cdhigh/PrinterCnc/Firmware/cmdlist.md

#绘图命令：
* x+00000 / x-00000
* y+00000 / y-00000
* z+00000 / z-00000
* 五位数字的单位为步进电机动作的步数。
* \+为向右或向下，\-为向左或向上。

#配置命令：
* XS000 / XE000 设定X轴的初始和最大移动速度，三位数字越小运动越快
* YS000 / YE000 设定Y轴的初始和最大移动速度，三位数字越小运动越快
* Z000 设定Z轴的移动速度，三位数字越小运动越快
* A0000 设定XY轴的加速过程加速度，四位数字越大加速越慢，为0则恒定初始速度
