cdhigh/PrinterCnc/Photos/DC电机加光栅条结构.JPG

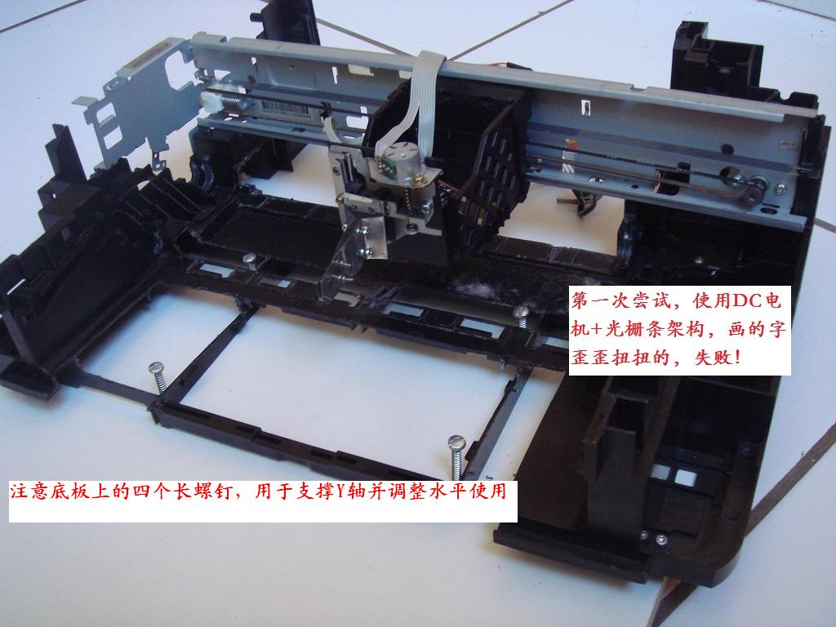
Photos/DC电机加光栅条结构.JPG
