cdhigh/PrinterCnc/Photos/DC电机驱动板.JPG

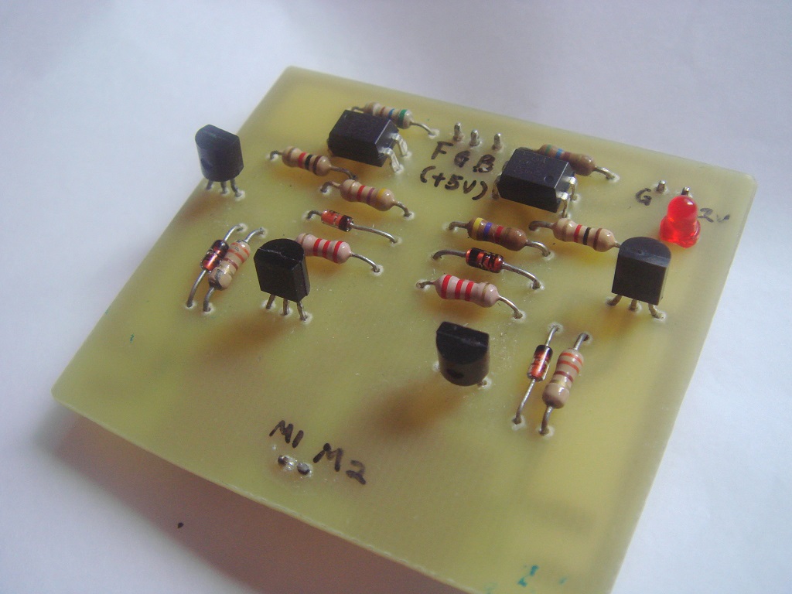
Photos/DC电机驱动板.JPG
