cdhigh/PrinterCnc/Photos/DC电机驱动板电路图.JPG

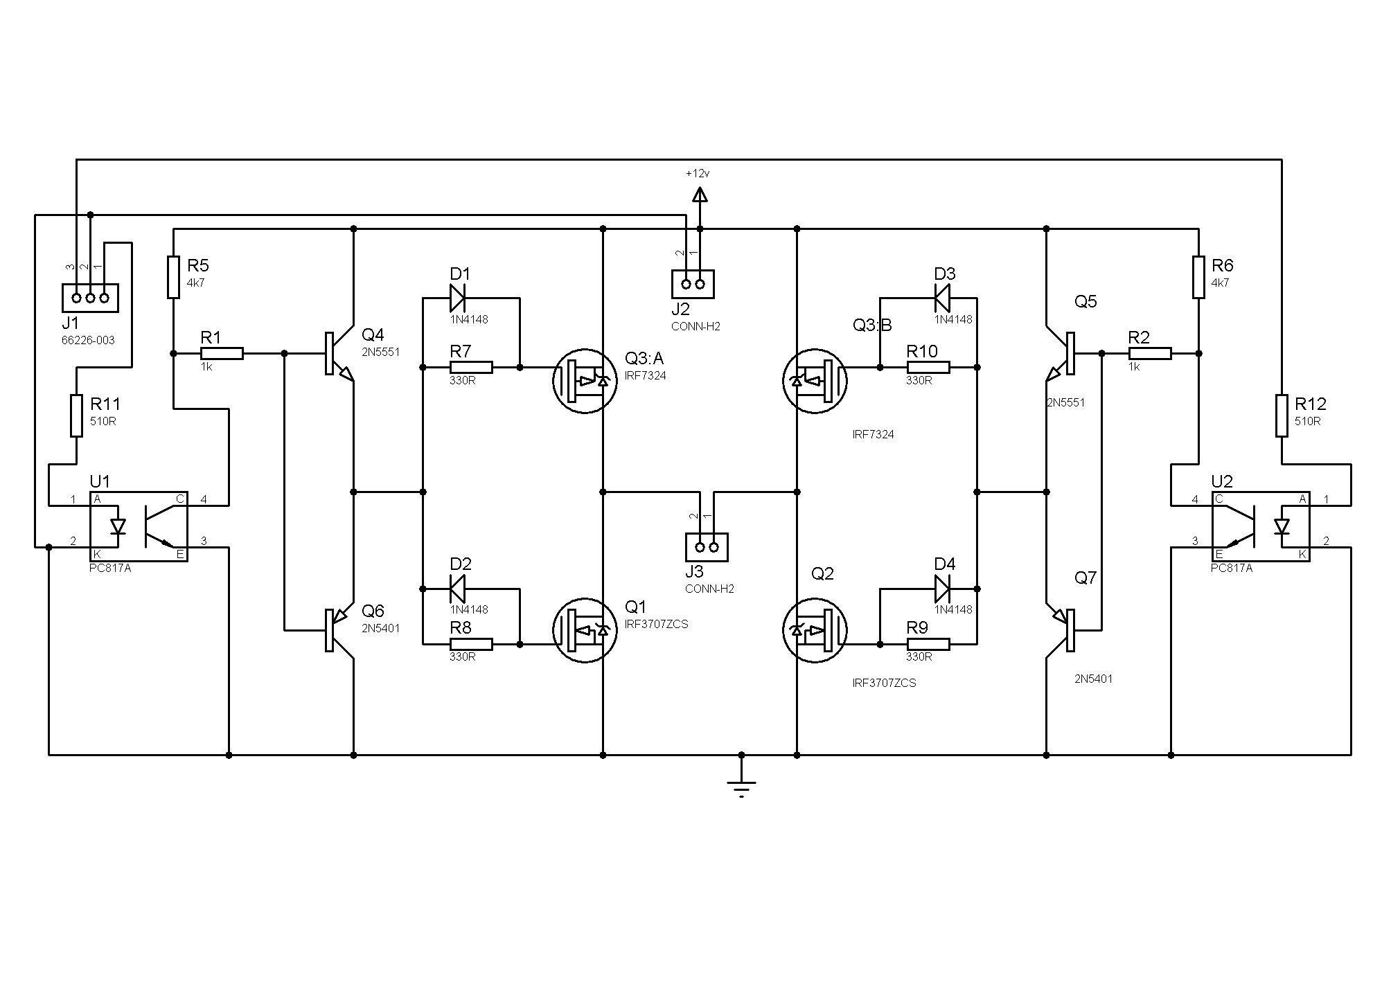
Photos/DC电机驱动板电路图.JPG
