cdhigh/PrinterCnc/Photos/DC电机驱动板背面.JPG

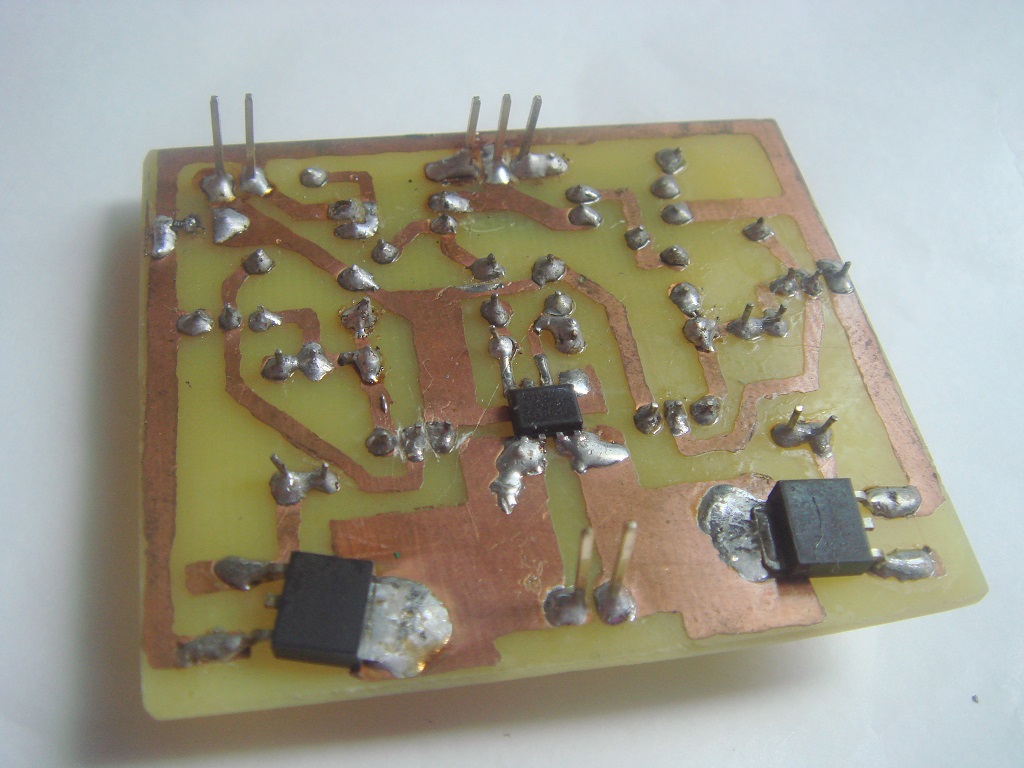
Photos/DC电机驱动板背面.JPG
