cdhigh/PrinterCnc/Photos/JDM编程器.JPG

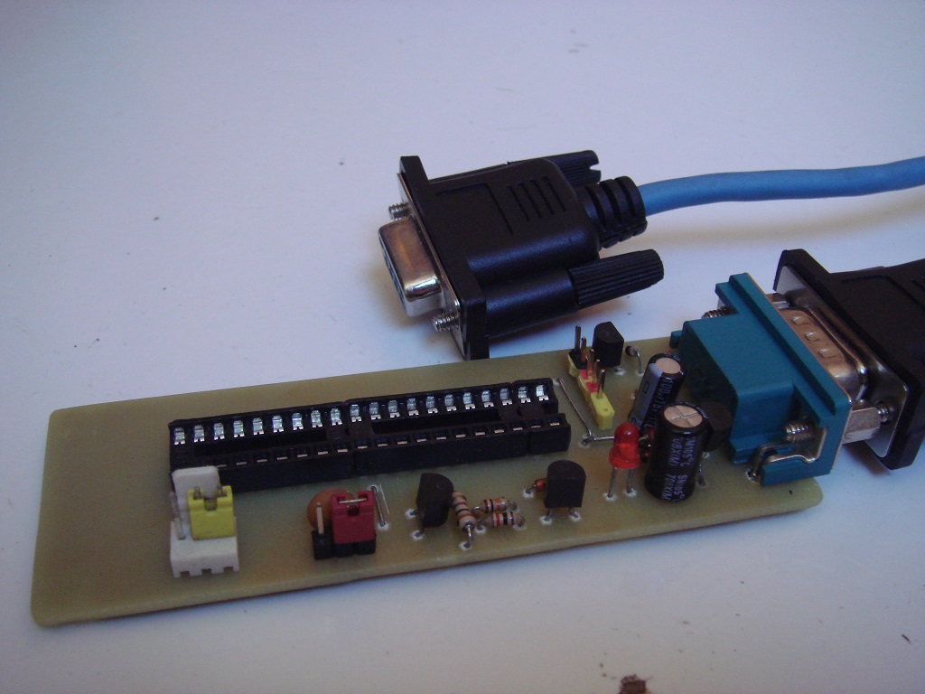
Photos/JDM编程器.JPG
