cdhigh/PrinterCnc/Photos/X轴步进电机齿轮组正面.JPG

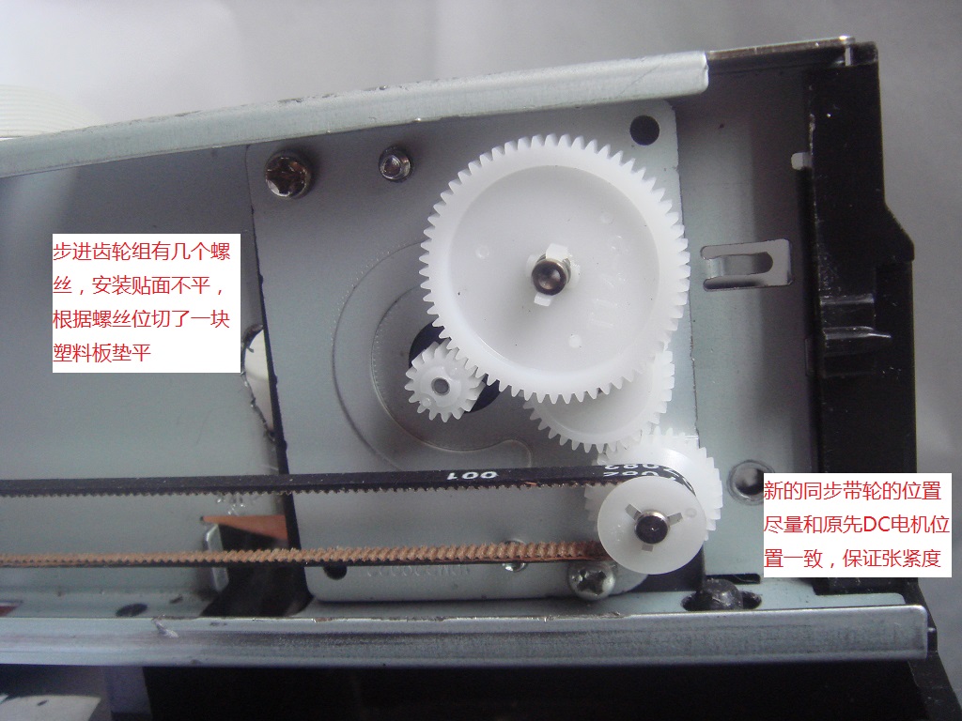
Photos/X轴步进电机齿轮组正面.JPG
