cdhigh/PrinterCnc/Photos/X轴步进电机齿轮组背面.JPG

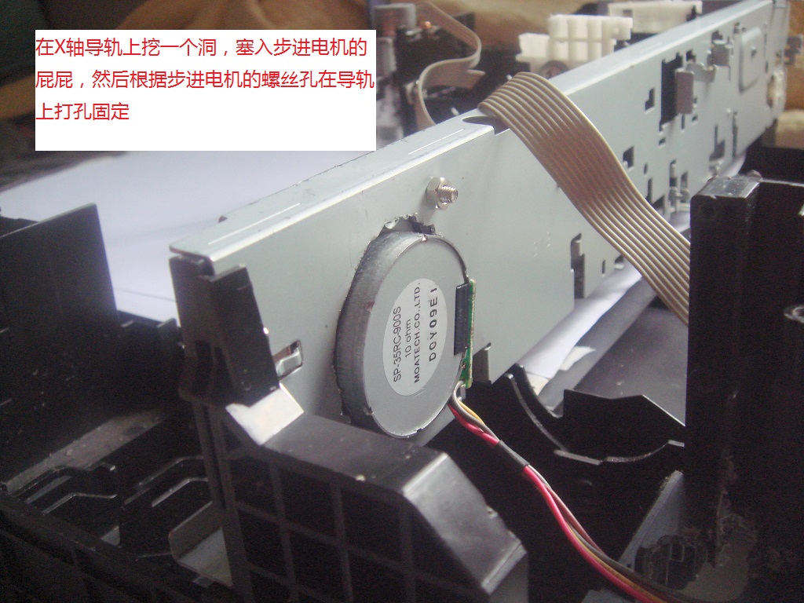
Photos/X轴步进电机齿轮组背面.JPG
