cdhigh/PrinterCnc/Photos/Y轴支撑平台固定角铝.JPG

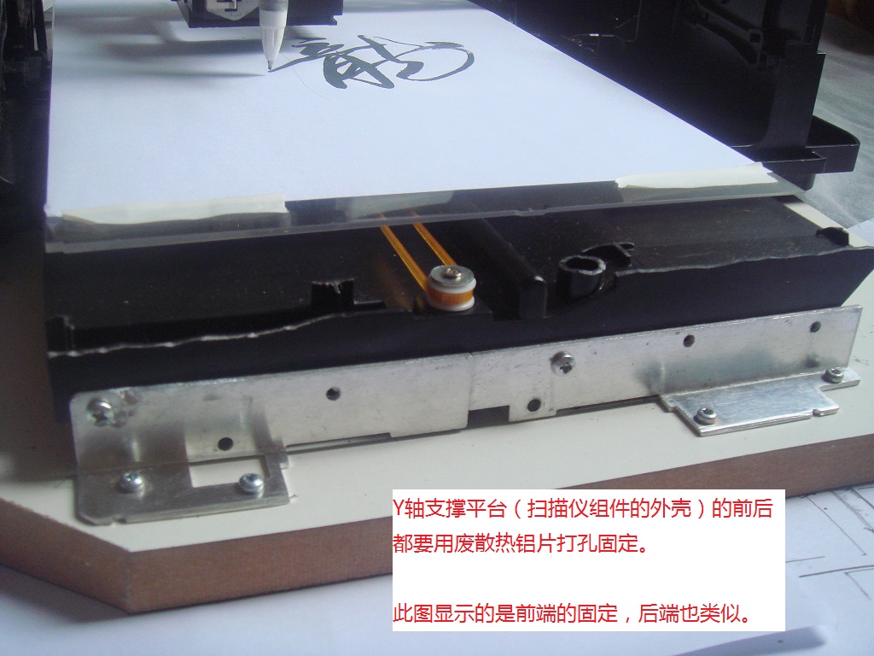
Photos/Y轴支撑平台固定角铝.JPG
