cdhigh/PrinterCnc/Photos/Z轴笔架固定特写.JPG

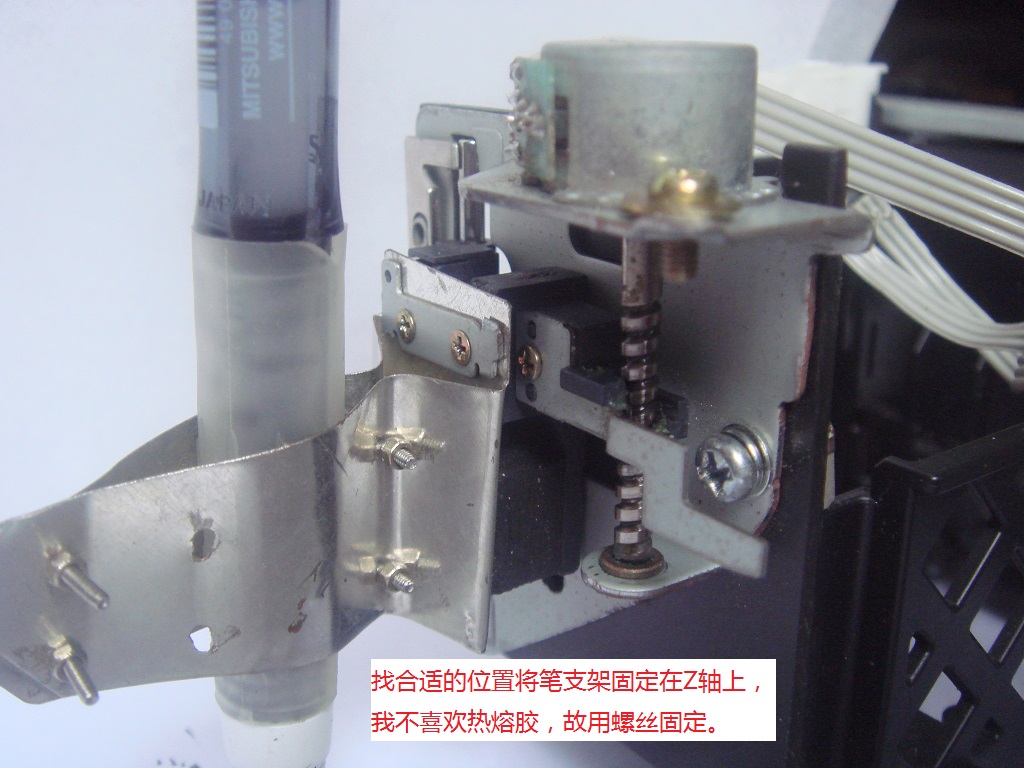
Photos/Z轴笔架固定特写.JPG
