cdhigh/PrinterCnc/Photos/墨车固定和Z轴特写.JPG

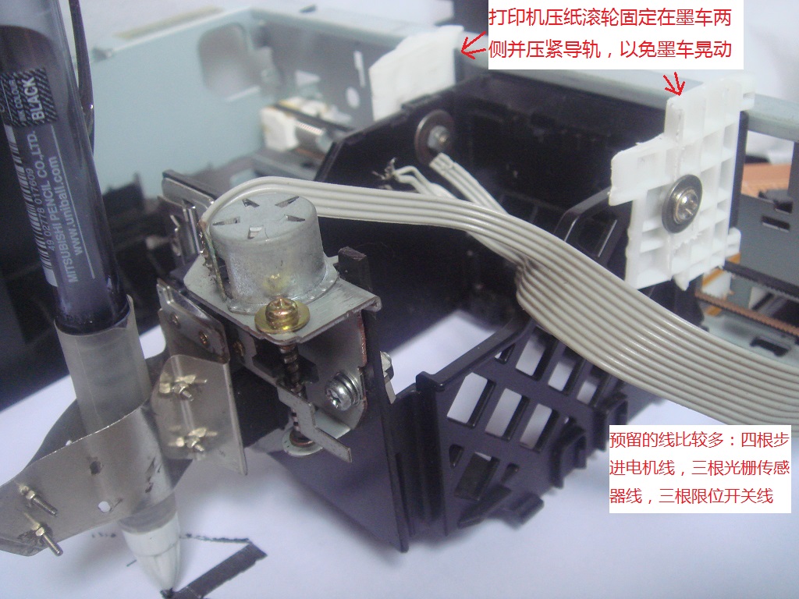
Photos/墨车固定和Z轴特写.JPG
