cdhigh/PrinterCnc/Photos/扫描仪组件改装.JPG

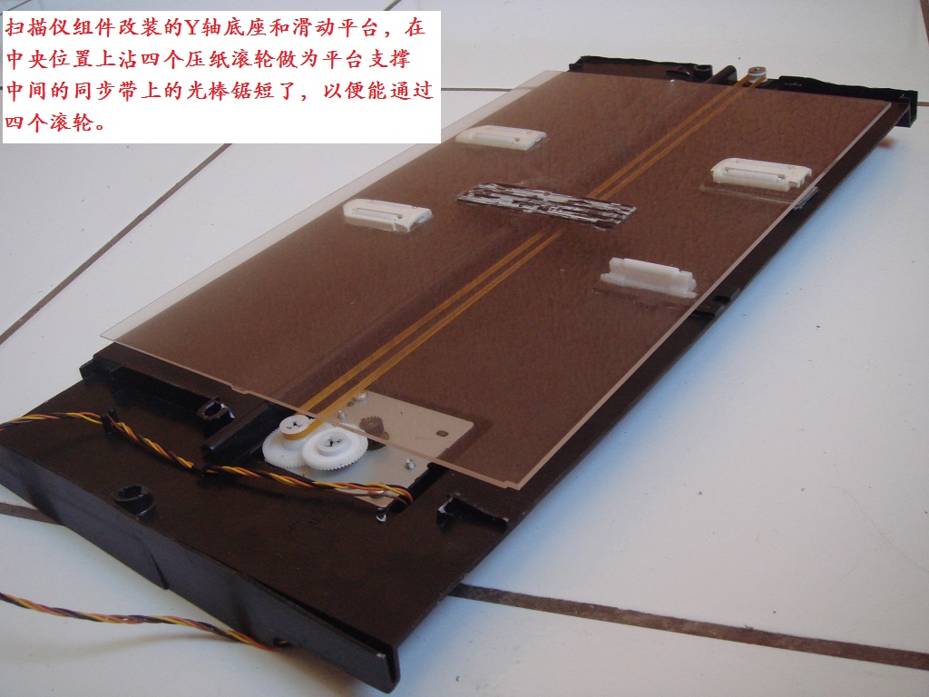
Photos/扫描仪组件改装.JPG
