cdhigh/PrinterCnc/Photos/控制板盒子.JPG

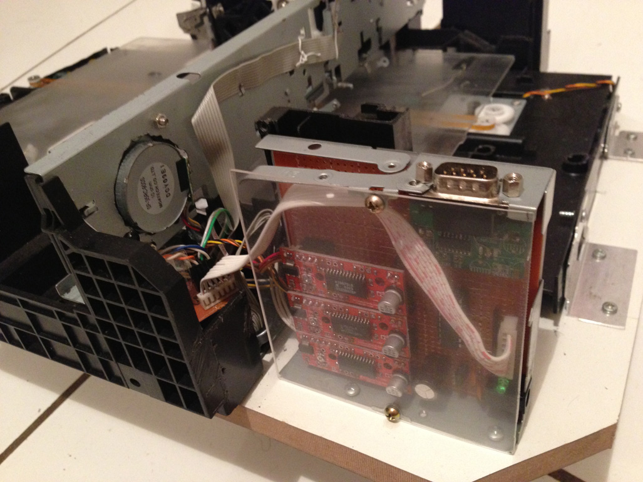
Photos/控制板盒子.JPG
