cdhigh/PrinterCnc/Photos/最终控制板.JPG

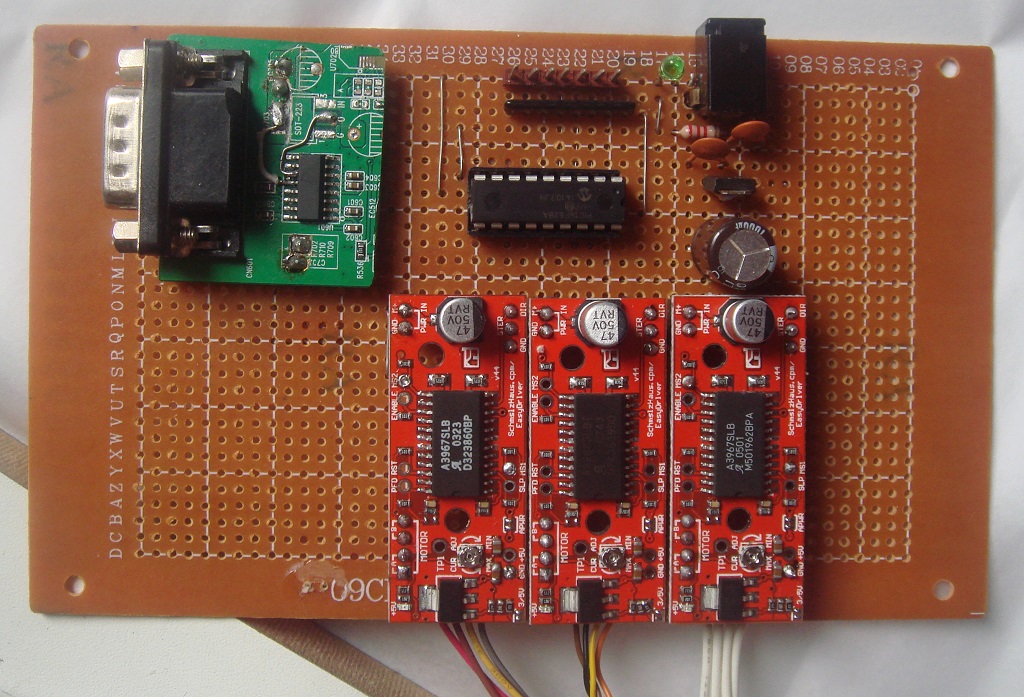
Photos/最终控制板.JPG
