cdhigh/PrinterCnc/Photos/最终洞洞板背面.JPG

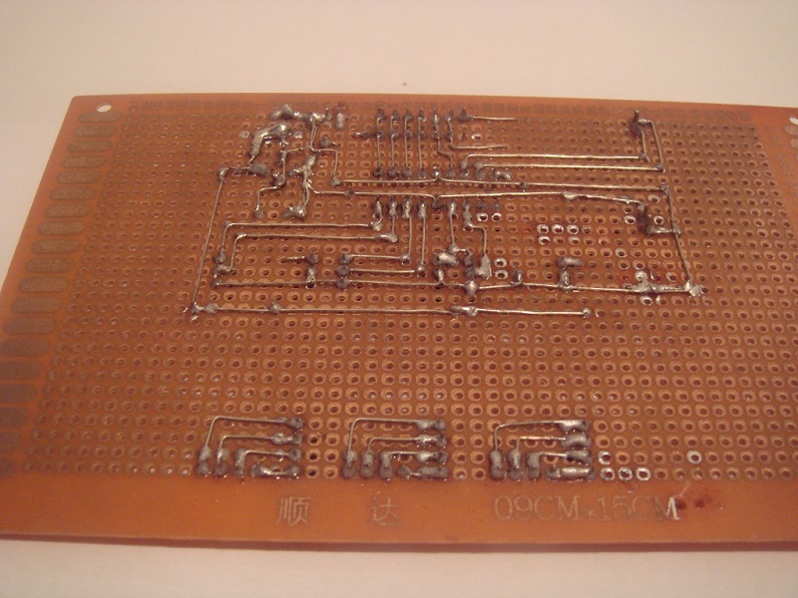
Photos/最终洞洞板背面.JPG
