cdhigh/PrinterCnc/Photos/最终洞洞板（没EasyDriver）.JPG

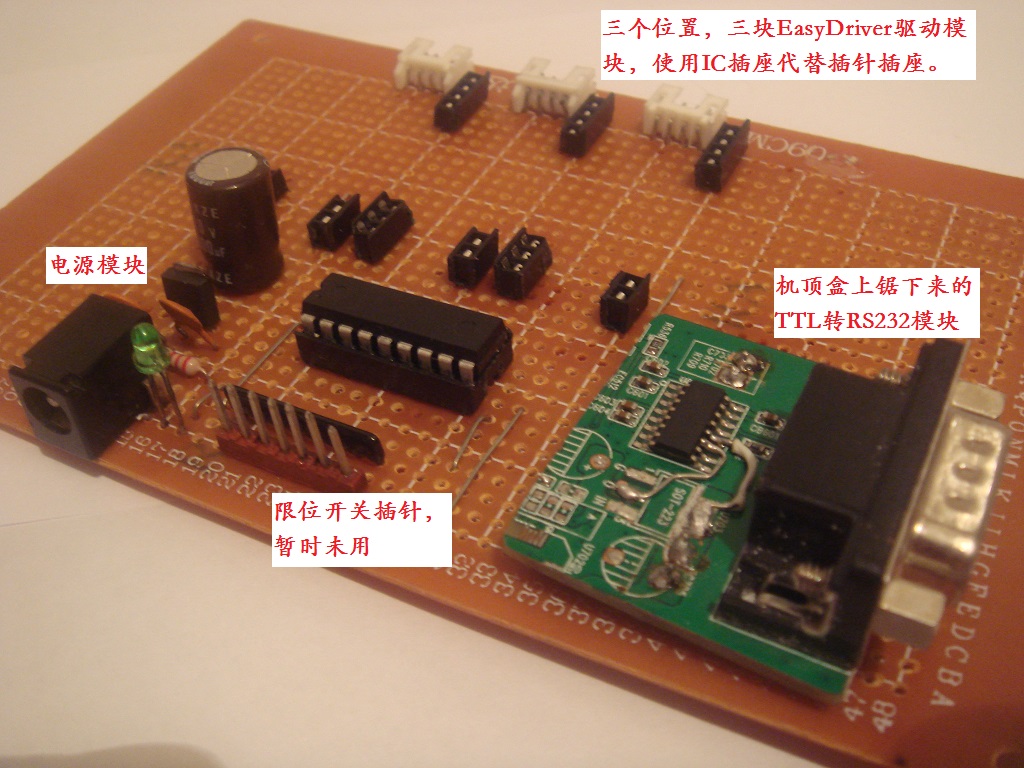
Photos/最终洞洞板（没EasyDriver）.JPG
