cdhigh/PrinterCnc/Photos/滚轮特写.JPG

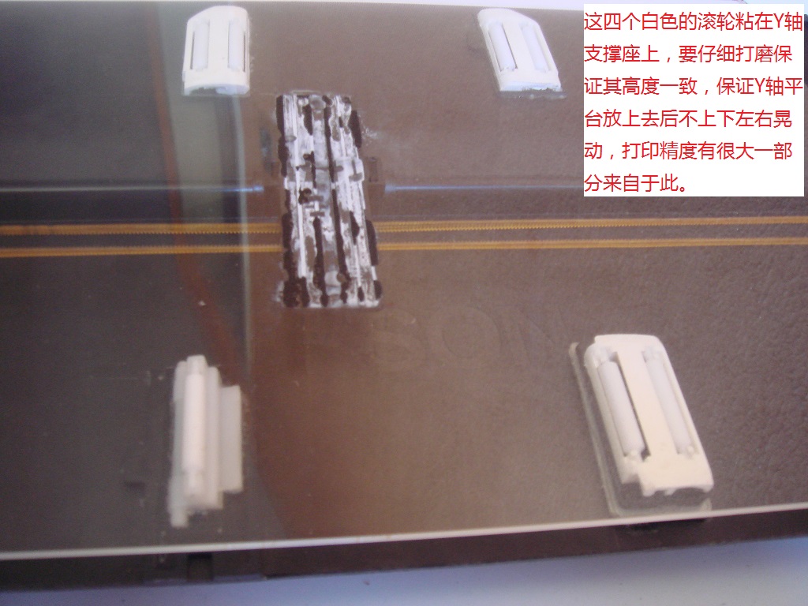
Photos/滚轮特写.JPG
