cdhigh/PrinterCnc/Photos/第一次尝试洞洞板.JPG

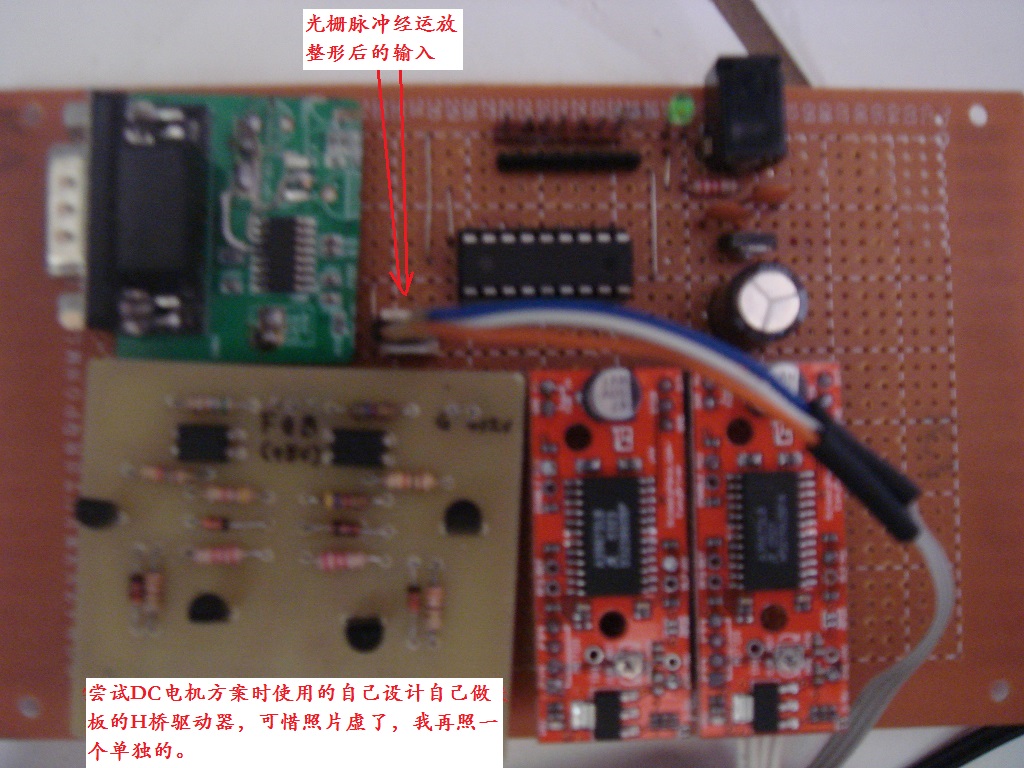
Photos/第一次尝试洞洞板.JPG
