cdhigh/PrinterCnc/Reference/JDM Programer/jdm programer.BMP

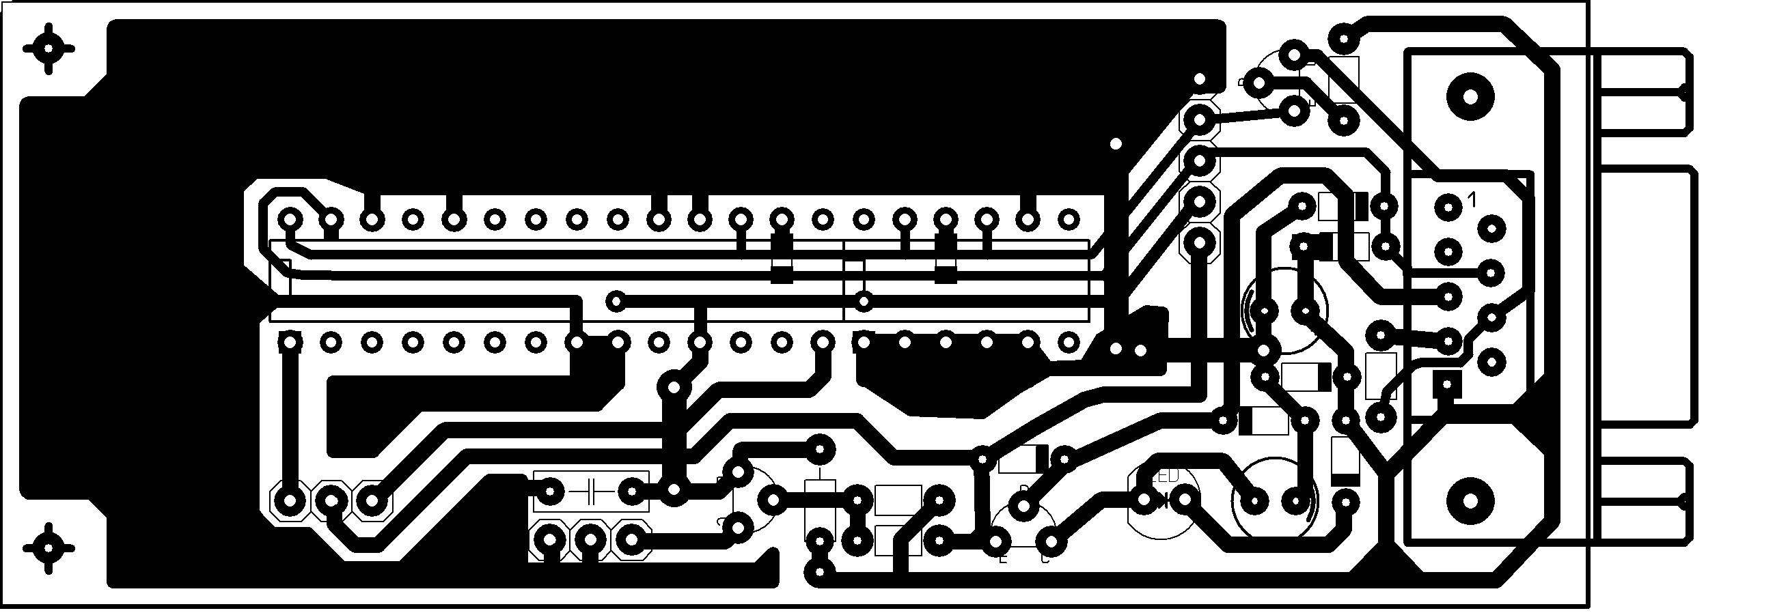
Reference/JDM Programer/jdm programer.BMP
