cdhigh/PrinterCnc/Reference/控制板LochMaster4工程/雕刻机控制板.jpg

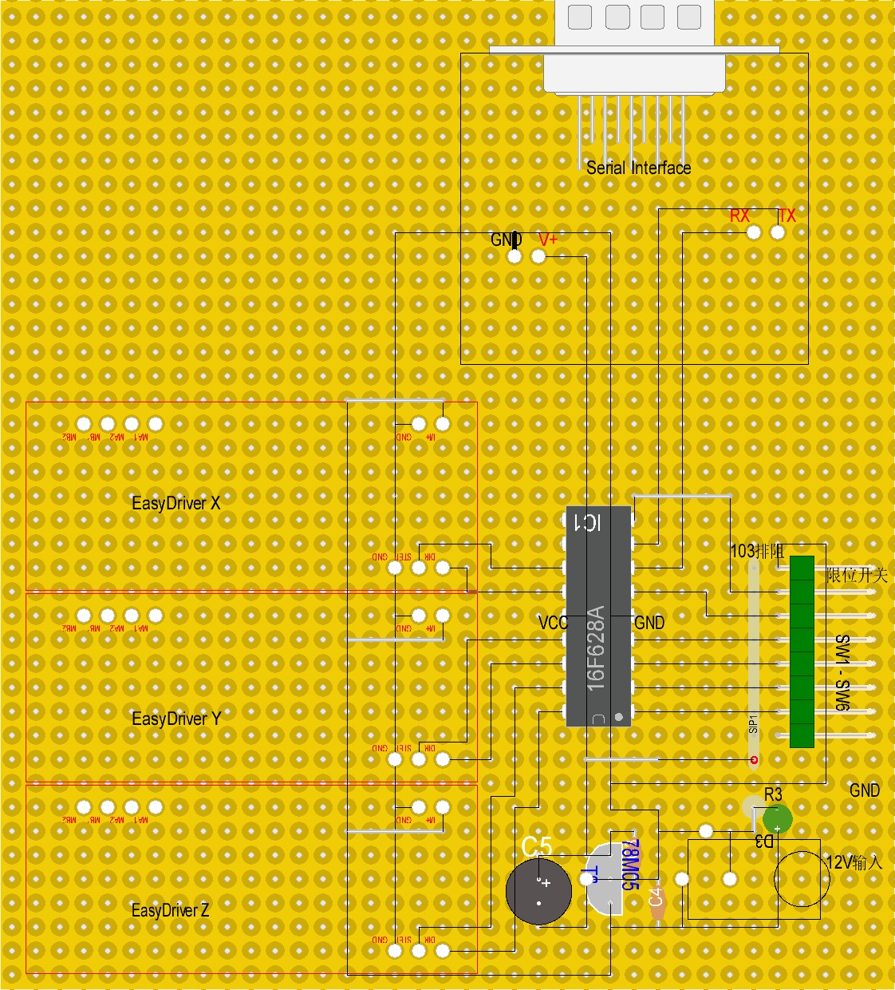
Reference/控制板LochMaster4工程/雕刻机控制板.jpg
