cdhigh/PrinterCnc/Reference/Datasheet/EasyDriver_v44/EasyDriver_v44_BOM.xls

EasyDriver V4.4 BOM
Qty | Ref | Description | Mfg Part Number | Disti part number | Distributor | Price @1 | Price @100 | Total Price @1 | Total Price @100
1 | IC1 | A3967 driver chip | A3967SLBTR-T | 59P3273 | Newark | 2.75 | 1.71 | 2.75 | 1.71
1 | C3 | CAP 47UF 35V ELECT MZA SMD | EMZA350ADA470MF61G | 565-2558-1-ND | DigiKey | 0.75 | 0.39 | 0.75 | 0.39
1 | C1 | CAP CER .10UF 50V Y5V 0603 | C1608Y5V1H104Z | 445-1324-1-ND | DigiKey | 0.04 | 0.02 | 0.04 | 0.02
2 | C4,C5 | CAP 680PF 50V CERAMIC X7R 0603 | CC0603KRX7R9BB681 | 311-1188-1-ND | DigiKey | 0.05 | 0.03 | 0.10 | 0.07
2 | R3,R4 | RES 20K OHM 1/10W 5% 0603 SMD | MCR03EZPJ203 | RHM20KGCT-ND | DigiKey | 0.07 | 0.02 | 0.14 | 0.04
2 | R1,R2 | RES .75 OHM 1/4W 1% 0805 SMD | MCR10EZHFLR750 | RHM.75MCT-ND | DigiKey | 0.14 | 0.10 | 0.28 | 0.20
1 | IC2 | IC REG ADJ 3-TERM SOT-223-4 | LM317MDCYR | 296-12631-1-ND | DigiKey | 0.80 | 0.45 | 0.80 | 0.45
1 | C2 | CAP 1UF 10V CER Y5V SMD 0603 | C0603C105Z8VACTU | 399-3216-1-ND | DigiKey | 0.04 | 0.03 | 0.04 | 0.03
1 | R16 | TRIMPOT 10K OHM 3MM CERMET SMD | TC33X-2-103E | TC33X-103ECT-ND | DigiKey | 0.20 | 0.14 | 0.20 | 0.14
1 | R5 | RES 5.1K OHM 1/10W 5% 0603 SMD | RC0603JR-075K1L | 311-5.1KGRCT-ND | DigiKey | 0.06 | 0.02 | 0.06 | 0.02
1 | PWR_LED | LED YELLOW 591NM 0603 SMD (2mA, 1.8V) | LY L29K-H1K2-26 | 475-1196-1-ND | DigiKey | 0.13 | 0.11 | 0.13 | 0.11
6 | R10,R11,R12,R13,R14,R15 | RES 10K OHM 1/10W 5% 0603 SMD | ERJ-3GEYJ103V | P10KGCT-ND | DigiKey | 0.07 | 0.02 | 0.43 | 0.13
1 | R9 | RES 1.0K OHM 1/10W 5% 0603 SMD | ERJ-3GEYJ102V | P1.0KGCT-ND | DigiKey | 0.07 | 0.02 | 0.07 | 0.02
1 | R8 | RES 240 OHM 1/10W 5% 0603 SMD | ERJ-3GEYJ241V | P240GCT-ND | DigiKey | 0.07 | 0.02 | 0.07 | 0.02
1 | R7 | RES 715 OHM 1/10W 1% 0603 SMD | ERJ-3EKF7150V | P715HCT-ND | DigiKey | 0.07 | 0.02 | 0.07 | 0.02
1 | R6 | RES 910 OHM 1/10W 5% 0603 SMD | ERJ-3GEYJ911V | P910GCT-ND | DigiKey | 0.07 | 0.02 | 0.07 | 0.02
1 | R17 | Do not populate at production | - | - | - | - | - | - | -
1 |  | PWB |  |  | Gold Phoenix | 1.00 | 1.00 | 1.00 | 1.00
 |  |  |  | Total |  |  |  | 7.01 | 4.41
