cdhigh/PrinterCnc/(list of files, drawings)

Other design files:
Reference/DC电机驱动Protues工程/MotorControl.pdsprj
Reference/JDM Programer/jdm programer.lay6
