cdhigh/PrinterCnc/Software/CncController.ini

[Main]
serialtimeout = 1s x 120
forcehole = 0
minimumhole = 0.8
keeplognum = 100
minimumx = 3000.0
minimumy = 3000.0
shiftx = 0.0
shifty = 0.0
omitregioncmd = 0
sortcommands = 1

[Simulator]
width = 110

[Machine]
xaxisspeed = 100
xaxismaxspeed = 50
yaxisspeed = 120
yaxismaxspeed = 50
zaxisspeed = 80
speedacceleration = 100
xstepspercm = 1886
xbacklash = 94
ystepspercm = 1886
ybacklash = 0
zliftsteps = 130
pendiameter = 0.6
