cdhigh/PrinterCnc/Software/CncSimulator.py

#!/usr/bin/env python
#-*- coding:utf-8 -*-
"""
废喷墨打印机改装的大行程数控雕刻机的PC控制端程序的模拟器
因为我的PC控制端程序并不支持所有的RS274X标准，所以此模拟器是有必要的，
可以在实际输出到控制板之前先查看实际结果，避免不必要的时间和物料浪费。
当然，因为python直接绘图，效率是比较低的，速度是比较慢的，如果图像稍大，使用要有点耐心。

Author：
    cdhigh <https://github.com/cdhigh>
License:
    The MIT License (MIT)
第一版完成日期：
    2015-05-14
"""

import os, sys
try:
    from tkinter import *
except ImportError:  #Python 2.x
    PythonVersion = 2
    from Tkinter import *
    from tkFont import Font
    from ttk import *
    #Usage:showinfo/warning/error,askquestion/okcancel/yesno/retrycancel
    from tkMessageBox import *
    #Usage:f=tkFileDialog.askopenfilename(initialdir='E:/Python')
    #import tkFileDialog
    #import tkSimpleDialog
else:  #Python 3.x
    PythonVersion = 3
    from tkinter.font import Font
    from tkinter.ttk import *
    from tkinter.messagebox import *
    #import tkinter.filedialog as tkFileDialog
    #import tkinter.simpledialog as tkSimpleDialog    #askstring()

if getattr(sys, 'frozen', False): #在cxFreeze打包后
    __file__ = sys.executable
    
class Application_ui(Frame):
    #这个类仅实现界面生成功能，具体事件处理代码在子类Application中。
    def __init__(self, master=None):
        Frame.__init__(self, master)
        self.master.title('PrinterCnc模拟器 【绘图时比较慢，请耐心等候】')
        self.master.geometry('646x554')
        self.icondata = """
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
            GrmRHNmRHvmRIFl/AQEAOw="""
        self.iconimg = PhotoImage(data=self.icondata)
        self.master.tk.call('wm', 'iconphoto', self.master._w, self.iconimg)
        self.createWidgets()

    def createWidgets(self):
        self.top = self.winfo_toplevel()

        self.style = Style()

        self.cmdClear = Button(self.top, text='全部清除', command=self.cmdClear_Cmd)
        self.cmdClear.place(relx=0.854, rely=0.679, relwidth=0.125, relheight=0.045)

        self.txtXWidthVar = StringVar(value='200')
        self.txtXWidth = Entry(self.top, textvariable=self.txtXWidthVar)
        self.txtXWidth.place(relx=0.854, rely=0.13, relwidth=0.125, relheight=0.045)
        self.txtXWidthVar.trace('w', self.txtXWidth_Change)

        self.cavSim = Canvas(self.top, bg='#FFFFFF', takefocus=1)
        self.cavSim.place(relx=0.012, rely=0.014, relwidth=0.826, relheight=0.963)
        self.cavSim.bind('<Motion>', self.cavSim_Motion)

        self.style.configure('TlblYOrd.TLabel', anchor='w')
        self.lblYOrd = Label(self.top, style='TlblYOrd.TLabel')
        self.lblYOrd.place(relx=0.854, rely=0.549, relwidth=0.125, relheight=0.045)

        self.style.configure('TlblYOrdNotify.TLabel', anchor='w')
        self.lblYOrdNotify = Label(self.top, text='Y坐标(mm)', style='TlblYOrdNotify.TLabel')
        self.lblYOrdNotify.place(relx=0.854, rely=0.505, relwidth=0.125, relheight=0.031)

        self.style.configure('TlblXOrd.TLabel', anchor='w')
        self.lblXOrd = Label(self.top, style='TlblXOrd.TLabel')
        self.lblXOrd.place(relx=0.854, rely=0.433, relwidth=0.125, relheight=0.045)

        self.style.configure('TlblXYOrdNotify.TLabel', anchor='w')
        self.lblXYOrdNotify = Label(self.top, text='X坐标(mm)', style='TlblXYOrdNotify.TLabel')
        self.lblXYOrdNotify.place(relx=0.854, rely=0.39, relwidth=0.125, relheight=0.031)

        self.style.configure('TlblXWidth.TLabel', anchor='e')
        self.lblXWidth = Label(self.top, text='X宽度（mm）', style='TlblXWidth.TLabel')
        self.lblXWidth.place(relx=0.854, rely=0.087, relwidth=0.125, relheight=0.031)

        self.txtYHeightVar = StringVar(value='200')
        self.txtYHeight = Entry(self.top, state='readonly', textvariable=self.txtYHeightVar)
        self.txtYHeight.place(relx=0.854, rely=0.245, relwidth=0.125, relheight=0.045)

        self.style.configure('TlblYHeight.TLabel', anchor='e')
        self.lblYHeight = Label(self.top, text='Y高度（mm）', style='TlblYHeight.TLabel')
        self.lblYHeight.place(relx=0.854, rely=0.202, relwidth=0.125, relheight=0.031)

class Application(Application_ui):
    #这个类实现具体的事件处理回调函数。界面生成代码在Application_ui中。
    def __init__(self, master=None):
        Application_ui.__init__(self, master)
        self.zPrevPos = '1' #'1' = down, '2' = up
        self.xPrevPos = 0
        self.yPrevPos = 0
        
        self.xBacklash = 0
        self.yBacklash = 0
        self.xPrevMoveLeft = True
        self.yPrevMoveUp = True
        self.xStepsPerCm = 0
        self.yStepsPerCm = 0
        self.xPixelsPerStep = 0
        self.yPixelsPerStep = 0
        self.MirconsPerPixel = 0
        
    def setSimulatorWidth(self, width):
        self.txtXWidthVar.set(width)
    def simulatorWidth(self):
        return self.txtXWidthVar.get()
        
    #X宽度更新后刷新Y高度
    def txtXWidth_Change(self, *args):
        try:
            xWidth = int(self.txtXWidthVar.get())
        except:
            xWidth = 0
        
        if xWidth <= 0:
            #showinfo('出错啦', 'X宽度设置值非法，请设置为一个正整数值')
            return
        
        cavW = int(self.cavSim.winfo_width())
        cavH = int(self.cavSim.winfo_height())
        xHeight = cavH / cavW * xWidth
        self.txtYHeightVar.set('%d' % xHeight)
        
    def cmdClear_Cmd(self, event=None):
        idlst = self.cavSim.find_all()
        for o in idlst:
            self.cavSim.delete(o)
    
    #移动鼠标时显示坐标
    def cavSim_Motion(self, event=None):
        if not event:
            return
            
        #坐标转换
        cavW = int(self.cavSim.winfo_width())
        cavH = int(self.cavSim.winfo_height())
        try:
            simW = int(self.txtXWidthVar.get())
        except:
            return
        simH = cavH / cavW * simW
        if self.txtYHeightVar.get() != '%d' % simH:
            self.txtYHeightVar.set('%d' % simH)
        MmPerPixel = simW / cavW #每像素多少mm
        x = event.x * MmPerPixel
        y = event.y * MmPerPixel
        self.lblXOrd['text'] = '%.1f' % x
        self.lblYOrd['text'] = '%.1f' % y
    
    #接收绘图命令，仿真控制板的处理
    def putDrawCmd(self, cmd, penWidth):
        if penWidth is None: #非绘图命令
            return b'*'
        
        try:
            cmd = cmd.decode()
        except:
            pass
            
        return self.drawCmd(cmd, penWidth)
    
    def Reset(self, x=False, y=False, z=False):
        if x:
            self.xPrevPos = 0
        if y:
            self.yPrevPos = 0
        if z:
            self.zPrevPos = '1'
        
    def UpdateProperties(self):
        #坐标转换
        cavW = int(self.cavSim.winfo_width())
        cavH = int(self.cavSim.winfo_height())
        try:
            simW = float(self.txtXWidthVar.get()) #单位为毫米
            simH = float(self.txtYHeightVar.get())
        except:
            #showinfo('出错啦', '设置的XY宽度值无效，请更正后再继续')
            return False
        
        #每步多少像素
        self.xPixelsPerStep = cavW / (self.xStepsPerCm / 10 * simW)
        self.yPixelsPerStep = cavH / (self.yStepsPerCm / 10 * simH)
        self.MirconsPerPixel = simW * 1000 / cavW #每像素多少微米
        return True
        
    #绘图命令：格式：x+00000 y+00000 z+00000
    def drawCmd(self, cmd, penWidth):
        axis = cmd[0]
        dir = cmd[1]
        steps = int(cmd[2:])
        
        if axis == 'z':
            if dir == '-': #不管往上移多少，都认为抬起画笔
                self.zPrevPos = '2'
            else:
                self.zPrevPos = '1'
            return b'*'
        
        if axis == 'x':
            if (self.xPrevMoveLeft and dir == '+') or (not self.xPrevMoveLeft and dir == '-'):
                steps -= self.xBacklash
            
            if dir == '+':
                x = self.xPrevPos + steps * self.xPixelsPerStep
                self.xPrevMoveLeft = False
            else:
                x = self.xPrevPos - steps * self.xPixelsPerStep
                self.xPrevMoveLeft = True
            y = self.yPrevPos
        elif axis == 'y':
            if (self.yPrevMoveUp and dir == '+') or (not self.yPrevMoveUp and dir == '-'):
                steps -= self.yBacklash
            x = self.xPrevPos
            if dir == '+':
                y = self.yPrevPos + steps * self.yPixelsPerStep
                self.yPrevMoveUp = False
            else:
                y = self.yPrevPos - steps * self.yPixelsPerStep
                self.yPrevMoveUp = True
        
        if self.zPrevPos == '2':
            self.xPrevPos = x
            self.yPrevPos = y
            return b'*'
        
        lineWidth = int(penWidth / self.MirconsPerPixel)
        if lineWidth < 1:
            lineWidth = 1
        if self.xPrevPos == x and self.xPrevPos == y: #打点，而不是画线
            penHalf = lineWidth / 2 if lineWidth > 1 else 1
            self.cavSim.create_oval(x - penHalf, y - penHalf, x + penHalf, y + penHalf, fill='black', width=1)
        else:
            self.cavSim.create_line(self.xPrevPos, self.yPrevPos, x, y, width=lineWidth)
            
        self.xPrevPos = x
        self.yPrevPos = y
        
        return b'*'
            
if __name__ == "__main__":
    top = Tk()
    Application(top).mainloop()
