cdhigh/PrinterCnc/(commit log)

2015-05-12 先保存自己的修改点
2015-05-14 上载参考资料
    [EasyDriver_v44.brd, EasyDriver_v44.sch, EasyDriver_v44_BOM.xls, MotorControl.pdsprj, jdm programer.lay6]
2015-05-24 增加图标和修正模拟器宽度不对问题
2015-05-25 v1.0a
    算是第一个稳定而且功能齐备的版本发布。
2015-05-27 v1.0b
    对protel支持
2015-05-29 v1.0d
    增加对protel的支持
2015-06-07 v1.1
    接口修改
2015-06-09 v1.1.1
    优化小焊盘处理
2015-07-06 添加图片
2015-07-06 更新readme
2015-07-06 修改readme
2015-08-18 1.1.4
    添加走线自动绕过焊盘功能
2015-09-12 软件启动时将计算机的串口罗列出来
2016-01-03 v1.2
    增加命令排序功能，减少绘图笔空跑，提高绘图速度。
2016-01-04 v1.2.1
    将排序功能用cython重写，提高速度。
2016-05-08 添加视频链接
